kulamani007/clock-gated-mac-array/(commit log)

2026-08-18 Initial commit: completion-aware clock-gated MAC array with sparsity zero-skip cascade extension, simulation and Vivado synthesis validation
    [adder_tree_stage.v, adder_tree_stage_zs.v, completion_aware_gate.v, mac_array_and_cascade_top.v, mac_cascade_zs_top.v, pipelined_mac.v, pipelined_mac_naive.v, pipelined_mac_zs.v]
2026-09-08 Add FPGA implementation flow, DSP-friendly variant, and TCAS-II paper draft
    Implementation (Vivado 2023.2, xc7a100tcsg324-1, out of context, 4.0 ns):
    - Add pipelined_mac_zs_dsp.v: the input-registered zero-skip MAC with no
    datapath reset. DSP48E1 A/B/M pipeline registers accept only synchronous
    reset, so the previous async-reset style stranded every datapath register in
    fabric (AREG=BREG=MREG=0). Removing it gives AREG=BREG=MREG=PREG=8 and lets
    the accumulator carry chain fold into the DSP's own adder: 530 LUT / 328 FF
    / 63 CARRY4 / 283.0 MHz, against 789 / 546 / 127 / 269.8 MHz for the ungated
    baseline. tb_dsp_equiv.v proves the two variants bit-identical over 3031
    cycles and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
    [data_area.csv, data_power_rtl.csv, summary_area.csv, summary_power.csv]
2026-09-08 Add sky130 standard-cell flow; separates architectural cost from FPGA artefact
    The Artix-7 results are entangled with the DSP48 hard macro: the datapath
    reset style decides whether the gated operand registers pack into the slice,
    which decides whether the multiplier can be quieted at all. A standard-cell
    flow has no hard multiplier, so it can tell the two apart.
    Adds asic/: Yosys 0.63 + ABC against the open sky130_fd_sc_hd library
    (typical, 25 C, 1.8 V), plus get_lib.ps1 to fetch the liberty file.
    Results (pre-layout cell area):
    baseline, 2-stage, async reset 111,244 um2 794 FF, 0 native-EN
    + split-enable zero-skip 113,032 um2 816 FF, 0 native-EN
    3-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
    [data_asic.csv]
2026-09-08 Add architecture figure to the paper (Fig. 1)
    The brief previously had no block diagram, which is unusual for a hardware
    paper and left readers to reconstruct the split-enable structure from prose
    and equations alone.
    Adds paper/fig_arch.tex, a full-width two-panel TikZ figure:
    (a) the cascade - array and adder tree each own an independent
    completion-aware gate sized to their own depth, with no central
    controller, and the update bus shown as the only wire the sparsity
    extension adds between stages;
    (b) one lane - ce_ctrl never masked and triggered by the raw valid, so the
    drain counter is structurally blind to sparsity, while ce_mult and
    ce_acc gate only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
